genko/relaxbox/PinAssignment.txt

 	receive				transmit
	(P0.0)UARTA			(P0.1)UARTA
	(P0.4)UARTB			P
	P0.5				(P0.5)UARTB
	P1.4				P1.7
	P1.5				P1.5
	P2.14				P2.14
	P2.15				P
	(P2.2)UARTC			P
	P2.5				(P2.5)UARTC
	P3.4				P3.5
	P4.0				P
	P5.0				P5.0
	P5.1				P5.1

	CAN receive			transmit
	P1.13				
	P1.4				P1.4
	P1.5				P1.5
	P1.8				P1.12 (CAN2)
	P14.3 (CAN1)			P1.9
	P2.6 (CAN2)			P2.7
					P3.2 (CAN1)

	P1.8 SPI-CS
        P1.1 SPI-CLK
        P1.4 SPI-MRST
        P1.5 SPI-MTSR
