genko/relaxbox/relaxbox.brd

## EAGLE design relaxbox.brd (2013-06-30)

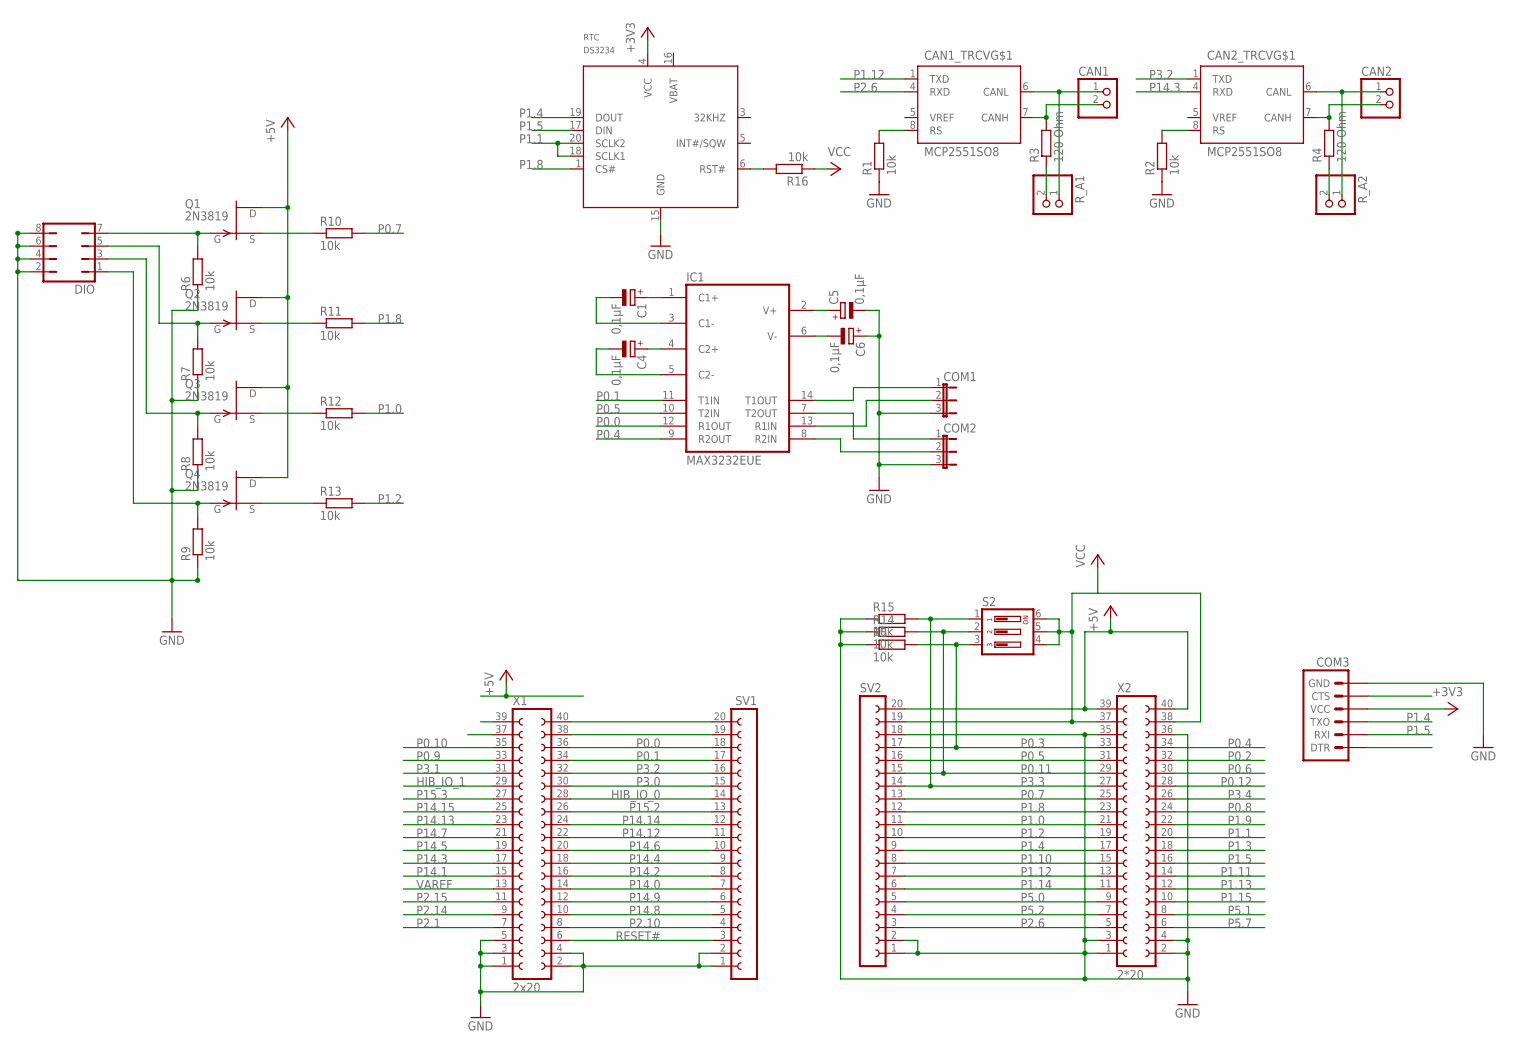
[picture p1: schematic relaxbox.sch]

Parts:
C1, C4, C5, C6: 0,1µF; E2,5-5
CAN1, CAN2: PINHD-1X2; 1X02
CAN1_TRCV, CAN2_TRCV: MCP2551SO8; SO08
COM1, COM2: JP2E; JP2
COM3: SPARKFUN_ARDUINO_SERIAL_PROGRAMPTH; SPARKFUN_1X06
DIO: JP4Q
IC1: MAX3232EUE; TSSOP16
Q1, Q2, Q3, Q4: 2N3819; TO92
R1, R2, R5, R6, R7, R8, R9, R10, R11, R12, R13, R14, R15, R16: 10k; M0805
R3, R4: 120 Ohm; M0805
RTC: DS3234; SO-20DW
R_A1, R_A2: PINHD-1X2; 1X02
S2: DIP03YL
SV1, SV2: FE20-1; FE20
X1: 2x20; FE20-2
X2: 2*20; FE20-2

Connections:
+3V3: COM3.4 (VCC), RTC.4 (VCC)
+5V: Q1.1 (D), Q2.1 (D), Q3.1 (D), Q4.1 (D), SV2.20, X2.39, X2.40
CANH1: CAN1.2, CAN1_TRCV.7 (CANH), R3.2
CANH2: CAN2.2, CAN2_TRCV.7 (CANH), R4.2
CANL1: CAN1.1, CAN1_TRCV.6 (CANL), R_A1.1
CANL2: CAN2.1, CAN2_TRCV.6 (CANL), R_A2.1
GND: C5.-, C6.+, CAN1_TRCV.2 (GND), CAN2_TRCV.2 (GND), COM1.3, COM2.3, COM3.6 (GND), DIO.2, DIO.4, DIO.6, DIO.8, IC1.15 (GND), R1.1, R2.1, R5.1, R6.1, R7.1, R8.1, R9.1, R14.1, R15.1, RTC.15 (GND), SV1.1, SV1.2, SV2.1, SV2.2, SV2.18, X1.1, X1.2, X1.3, X1.4, X1.5, X2.1, X2.2, X2.3, X2.4, X2.35, X2.36
HIB_IO_0: SV1.14, X1.28
HIB_IO_1: X1.29
unnamed: SV1.20, X1.40
unnamed: SV1.19, X1.38
unnamed: C1.+, IC1.1 (C1+)
unnamed: C1.-, IC1.3 (C1-)
unnamed: R16.2, RTC.6 (RST#)
unnamed: C4.+, IC1.4 (C2+)
unnamed: C4.-, IC1.5 (C2-)
unnamed: CAN1_TRCV.8 (RS), R1.2
unnamed: CAN2_TRCV.8 (RS), R2.2
unnamed: C5.+, IC1.2 (V+)
unnamed: C6.-, IC1.6 (V-)
unnamed: R3.1, R_A1.2
unnamed: R4.1, R_A2.2
unnamed: DIO.7, Q1.2 (G), R6.2
unnamed: Q1.3 (S), R10.1
unnamed: DIO.1, Q4.2 (G), R9.2
unnamed: DIO.3, Q3.2 (G), R8.2
unnamed: DIO.5, Q2.2 (G), R7.2
unnamed: Q2.3 (S), R11.1
unnamed: Q3.3 (S), R12.1
unnamed: Q4.3 (S), R13.1
unnamed: COM1.1, IC1.14 (T1OUT)
unnamed: COM1.2, IC1.13 (R1IN)
unnamed: COM2.1, IC1.7 (T2OUT)
unnamed: COM2.2, IC1.8 (R2IN)
P0.0: IC1.12 (R1OUT), SV1.18, X1.36
P0.1: IC1.11 (T1IN), SV1.17, X1.34
P0.2: X2.32
P0.3: R5.2, S2.3, SV2.17, X2.33
P0.4: IC1.9 (R2OUT), X2.34
P0.5: IC1.10 (T2IN), SV2.16, X2.31
P0.6: X2.30
P0.7: R10.2, SV2.13, X2.25
P0.8: X2.24
P0.9: X1.33
P0.10: X1.35
P0.11: R14.2, S2.2, SV2.15, X2.29
P0.12: X2.28
P1.0: R12.2, SV2.11, X2.21
P1.1: RTC.18 (SCLK1), RTC.20 (SCLK2), X2.20
P1.2: R13.2, SV2.10, X2.19
P1.3: X2.18
P1.4: COM3.3 (TXO), RTC.19 (DOUT), SV2.9, X2.17
P1.5: COM3.2 (RXI), RTC.17 (DIN), X2.16
P1.8: R11.2, RTC.1 (CS#), SV2.12, X2.23
P1.9: X2.22
P1.10: SV2.8, X2.15
P1.11: X2.14
P1.12: CAN1_TRCV.1 (TXD), SV2.7, X2.13
P1.13: X2.12
P1.14: SV2.6, X2.11
P1.15: X2.10
P2.1: X1.7
P2.6: CAN1_TRCV.4 (RXD), SV2.3, X2.5
P2.10: SV1.4, X1.8
P2.14: X1.9
P2.15: X1.11
P3.0: SV1.15, X1.30
P3.1: X1.31
P3.2: CAN2_TRCV.1 (TXD), SV1.16, X1.32
P3.3: R15.2, S2.1, SV2.14, X2.27
P3.4: X2.26
P5.0: SV2.5, X2.9
P5.1: X2.8
P5.2: SV2.4, X2.7
P5.7: X2.6
P14.0: SV1.7, X1.14
P14.1: X1.15
P14.2: SV1.8, X1.16
P14.3: CAN2_TRCV.4 (RXD), X1.17
P14.4: SV1.9, X1.18
P14.5: X1.19
P14.6: SV1.10, X1.20
P14.7: X1.21
P14.8: SV1.5, X1.10
P14.9: SV1.6, X1.12
P14.12: SV1.11, X1.22
P14.13: X1.23
P14.14: SV1.12, X1.24
P14.15: X1.25
P15.2: SV1.13, X1.26
P15.3: X1.27
RESET#: SV1.3, X1.6
VAREF: X1.13
VCC: CAN1_TRCV.3 (VCC), CAN2_TRCV.3 (VCC), IC1.16 (VCC), R16.1, S2.4, S2.5, S2.6, SV2.19, X2.37, X2.38

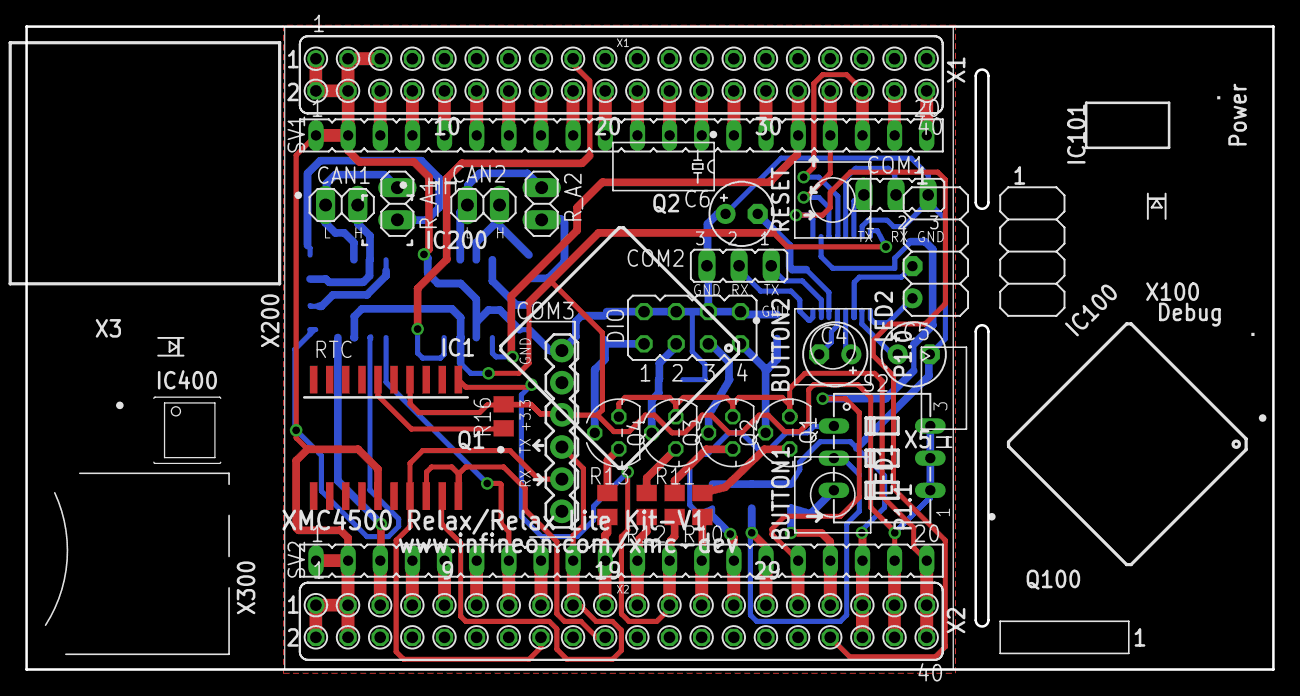
[picture p2: board relaxbox.brd from above]

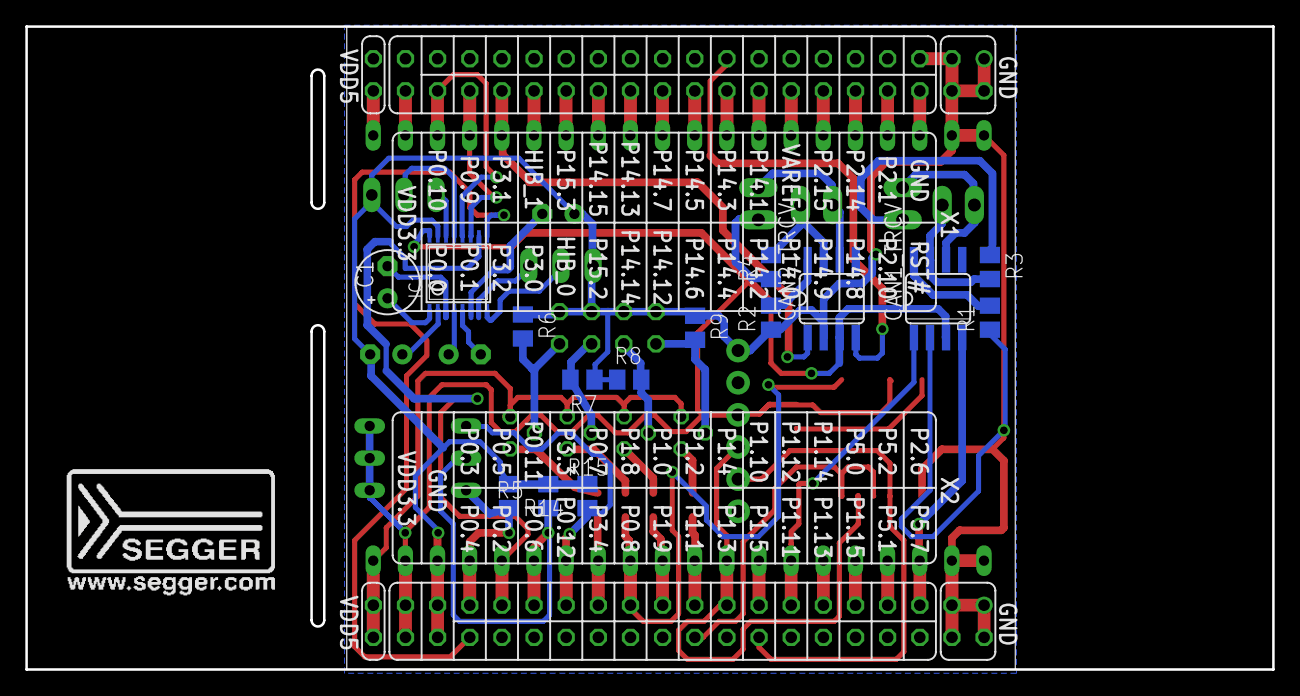
[picture p3: board relaxbox.brd from below]

Board: 2 copper layers, 98.5 x 50.8 mm, 41 parts (15 on the bottom side), 68 nets.
