genko/relaxbox/(commit log)

2013-03-15 Initial commit!
    [relaxbox.brd, relaxbox.sch]
2013-03-15 Adding UARTS from david
    [relaxbox.brd, relaxbox.sch]
2013-03-26 Schematic erweitert + Board placement
    [relaxbox.brd, relaxbox.sch]
2013-03-29 Library of Arduino Bluteooth module
2013-04-09 Added PinAssignment of usable UART and CAN pins.
2013-04-09 Entfernen von bereits verwendetem PIN aus CAN-Auswahl.
2013-04-11 Erster Routing Versuch. Um neue Verbindungen hinzuzufügen, einfach im Schematic hinzufügen und im Board Ratsnest ausführen.
    [relaxbox.brd, relaxbox.sch]
2013-04-19 Added SPI and CAN PINs.
    [relaxbox.brd, relaxbox.sch]
2013-04-20 Fixed pin assignment for SPI
2013-04-21 Optimized routing.
    [relaxbox.brd]
2013-04-21 Optimized DRC settings.
    [relaxbox.brd]
2013-04-22 Fixed pin assignment.
2013-04-25 Final list of Pin Assignment.
    [Pin_Assignment.xls]
2013-04-25 Changed Pin Assignment as it is not possible to run 4 USICs simultaneously.
    [relaxbox.brd, relaxbox.sch]
2013-04-25 Changed tPlace labels
    [relaxbox.brd, relaxbox.sch]
2013-04-27 Finish. Major change: COM1, COM2, COM3 had swapped RX and TX pins. --> fixed.
    [Pin_Assignment.xls, relaxbox.brd, relaxbox.sch]
2013-05-09 Teileliste und Bestellliste für Reichelt und Farnell
2013-06-30 Bugfix. VDD and 3,3V net were not connected. So the power supply of the CAN tranceivers and the MAX3232 were not connected to the 3,3V supply
    [relaxbox.brd, relaxbox.sch]
